cansat-tsniimash/CanSat-Monolit-2022/models/Снимок 2-3a.PNG

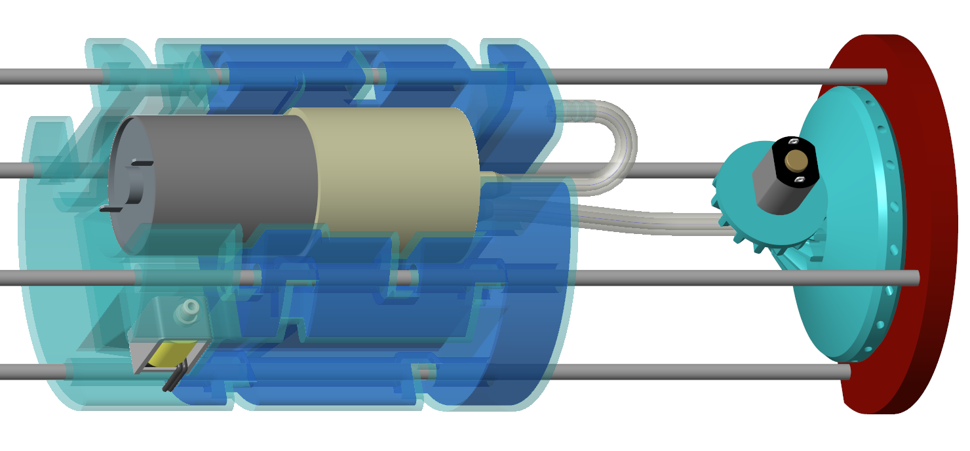
models/Снимок 2-3a.PNG
