cansat-tsniimash/CanSat-Monolit-2022/models/Снимок 1-1.PNG

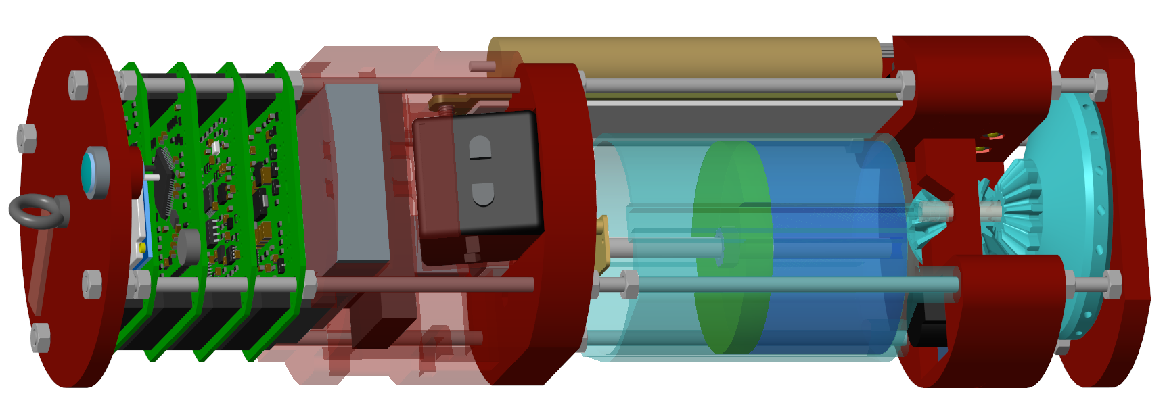
models/Снимок 1-1.PNG
