cansat-tsniimash/CanSat-Monolit-2022/doc/Сегмент парашюта.docx

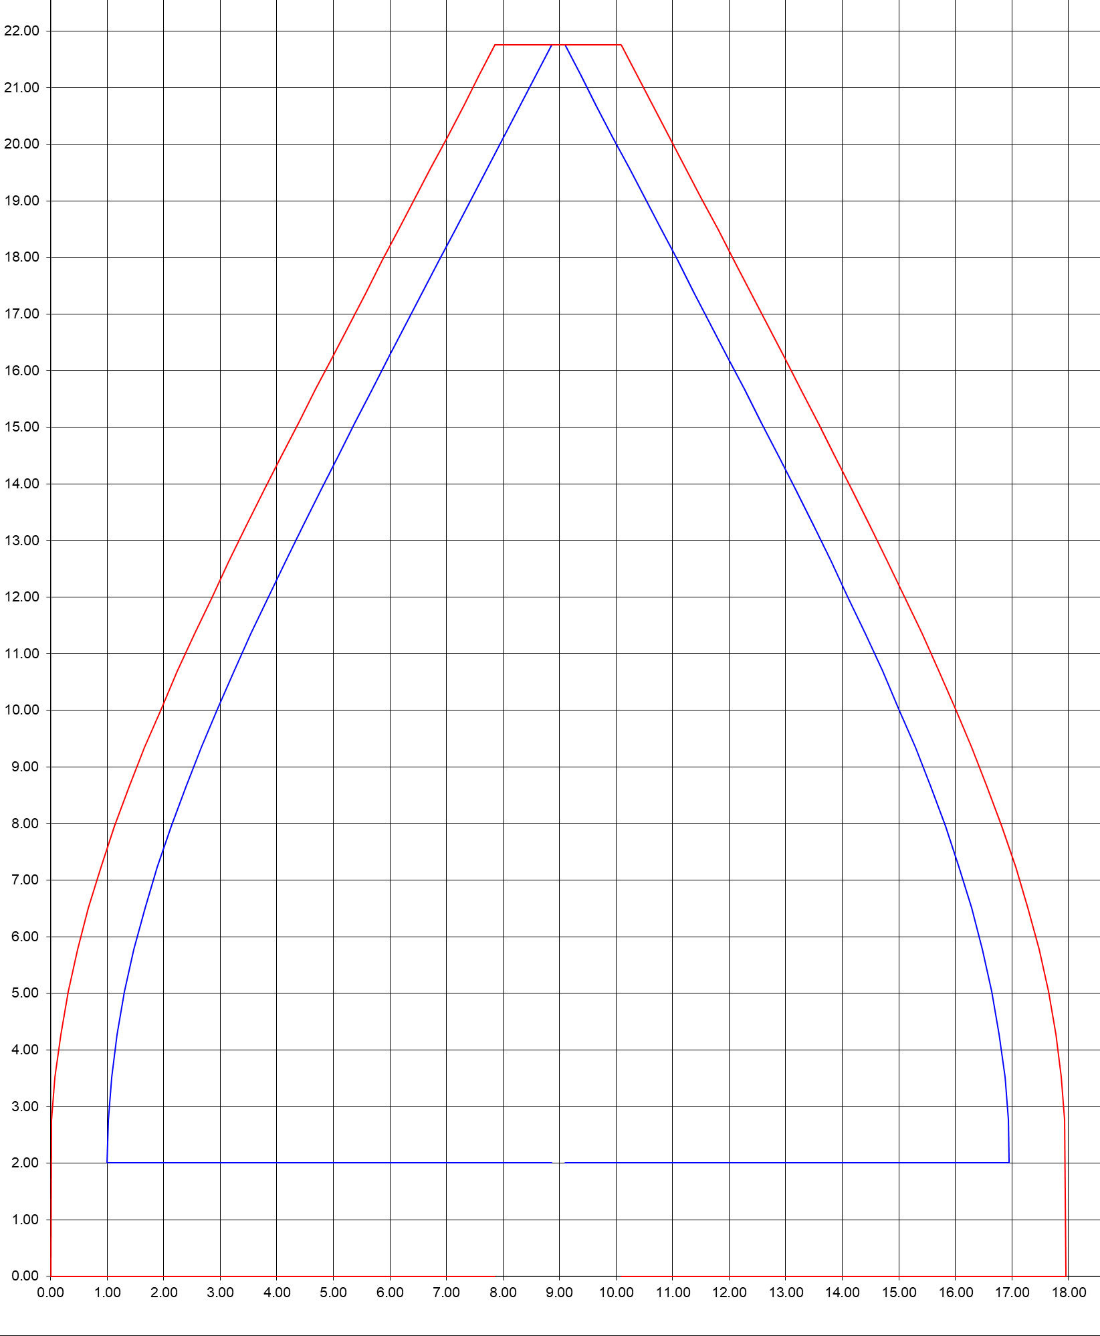
[picture p3: figure]
