cansat-tsniimash/CanSat-Monolit-2022/doc/Презентация Монолит.pdf

# Команда “Монолит”

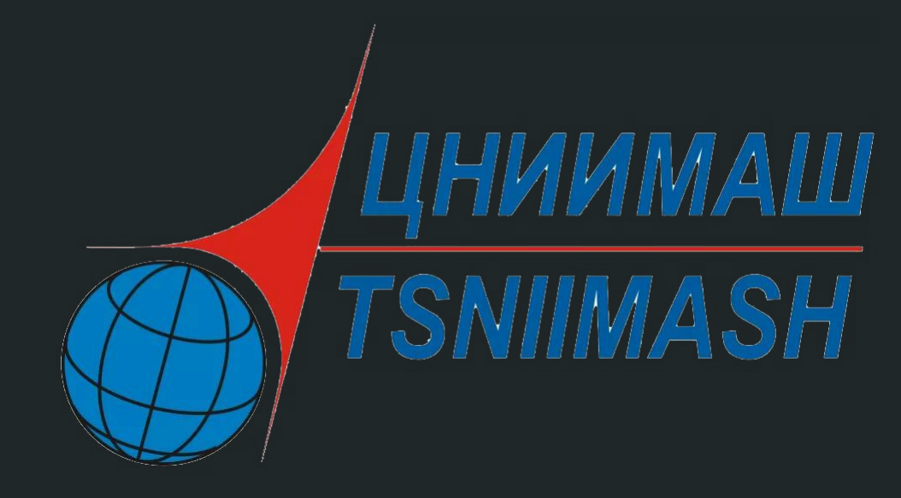
[picture p4: figure]

Проект
“Воздушно-инженерная школа (CanSat в России)”

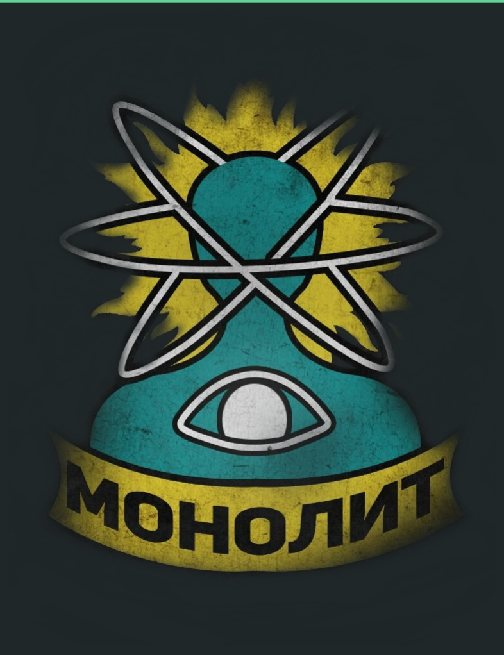
[picture p5: figure]

### Команда

### Алексеев Мирослав

Программист, схемотехник

### Зеленкевич Андрей

Конструктор, схемотехник

### Кулиш Павел

Программист

### Куратор

### Черкасова Марина

7 год участия в ВИШ

# Обязательные задачи проекта

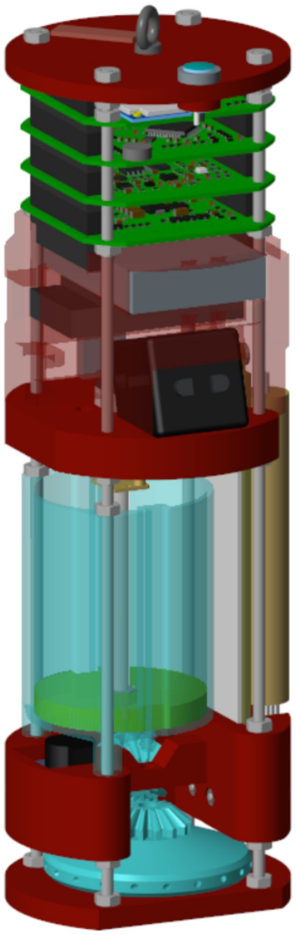
[picture p6: figure]
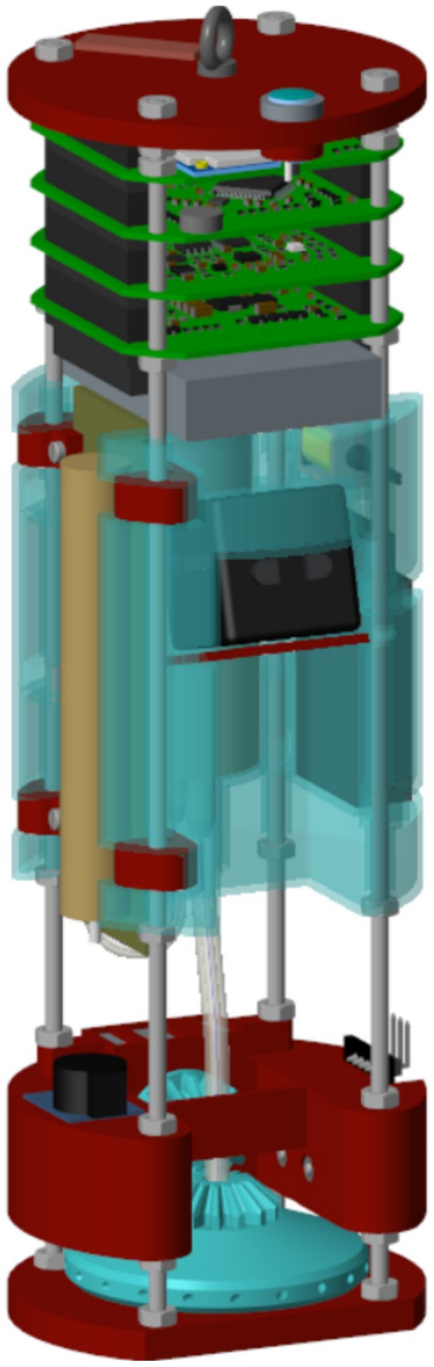
[picture p7: figure]

- Измерение распределения температуры и давления во время подъема и спуска
- Получение и интерпретация данных 3-х осевого акселерометра
- Обеспечение скорости спуска в пределах 5-11 м/c
- Передача данных измерений по обязательным исследовательским задачам в процессе полёта аппарата на приемную станцию
- Обеспечение работы бортового оборудования не менее 3 часов

# Исследовательская задача

### - Общая исследовательская задача - отработка технологий для

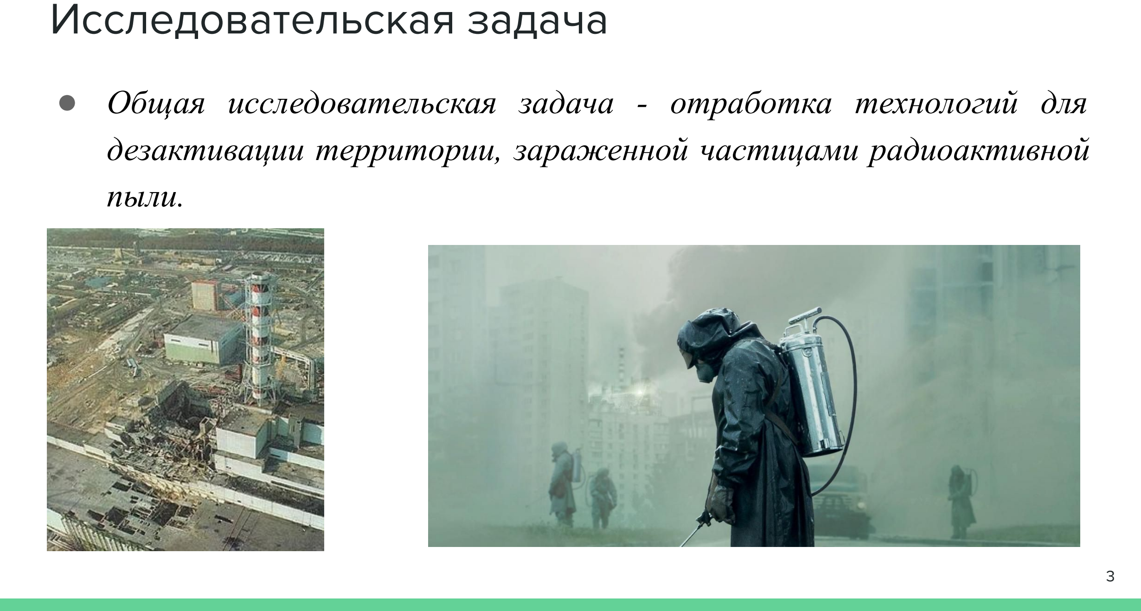
[picture p8: page 3]

### дезактивации территории, зараженной частицами радиоактивной

пыли.

- Измерение степени радиоактивного заражения территории
- Распыление дезактивирующей жидкости
- Видеосъемка процесса распыления жидкости
- Прием телеметрии аппарата на собственной наземной станции
- Использование радиомаяка для поиска аппарата
- Измерение влажности воздуха на протяжении полёта
- Сбор данных GPS о положении аппарата в пространстве
- Бесконтактная фиксация момента отделения от РН
- Световая индикация состояния миссии
- Сохранение телеметрии на SD карту
- Подача звукового сигнала (писк) для облегчения поиска аппарата
- Построение траектории полета аппарата (после приземления) | 4

# Дополнительные задачи проекта

# Схема деления аппарата

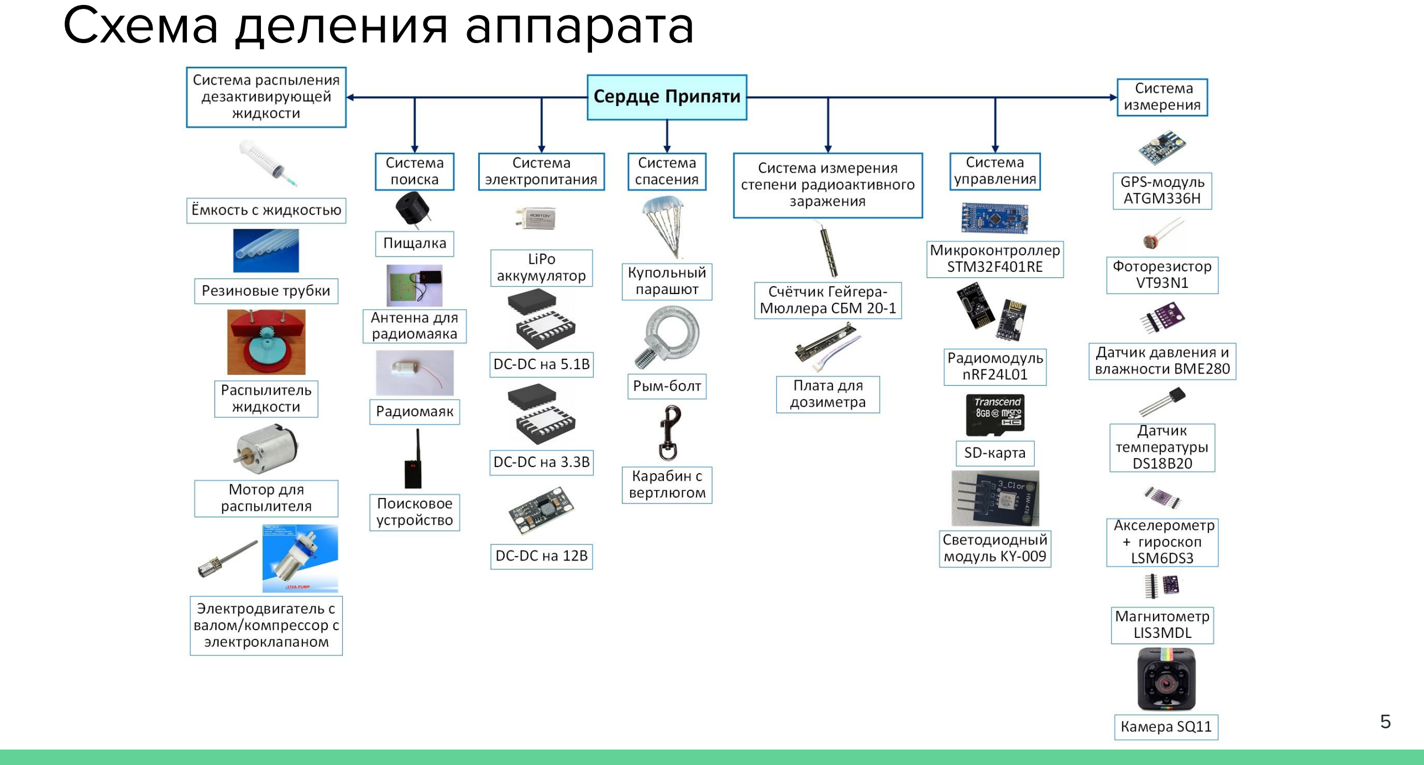
[picture p9: page 5]

# Компоновочная схема аппарата

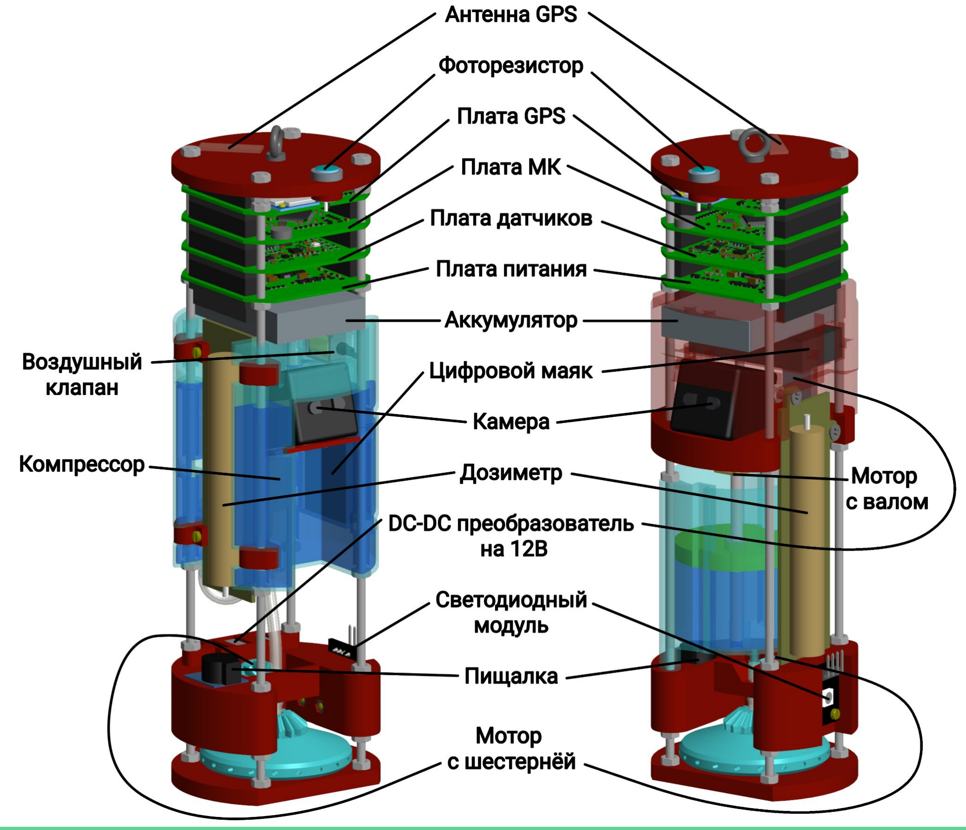
[picture p10: figure]

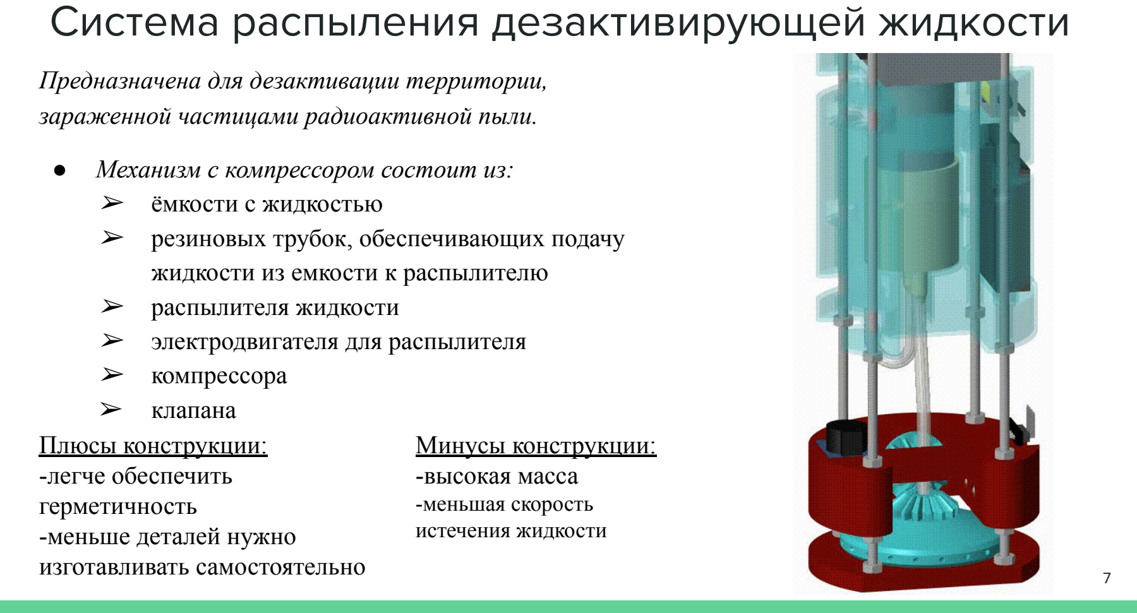
[picture p11: figure]
● Механизм с компрессором состоит из: ➢ ёмкости с жидкостью; жидкости из емкости к распылителю ➢ распылителя жидкости; ➢ электродвигателя для распылителя; ➢ компрессора; ➢ клапана; Плюсы конструкции: -легче обеспечить герметичность -меньше деталей нужно изготавливать самостоятельно; Минусы конструкции: -высокая масса -меньшая скорость истечения жидкости

- резиновых трубок, обеспечивающих подачу

# Система распыления дезактивирующей жидкости

Предназначена для дезактивации территории,
зараженной частицами радиоактивной пыли.

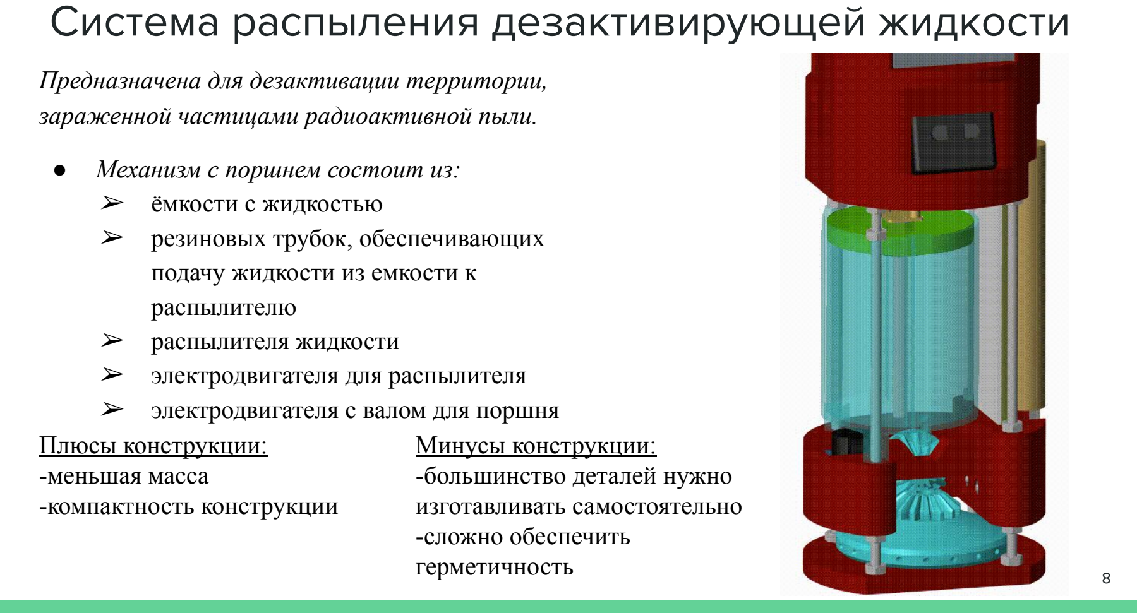
[picture p12: figure]
● Механизм с поршнем состоит из: ➢ ёмкости с жидкостью; ➢ резиновых трубок, обеспечивающих; подачу жидкости из емкости к; распылителю ➢ распылителя жидкости; ➢ электродвигателя для распылителя; ➢ электродвигателя с валом для поршня; Плюсы конструкции: -меньшая масса -компактность конструкции; Минусы конструкции: -большинство деталей нужно изготавливать самостоятельно -сложно обеспечить герметичность

# Система распыления дезактивирующей жидкости

Предназначена для дезактивации территории,
зараженной частицами радиоактивной пыли.

# Исследование радиационной обстановки

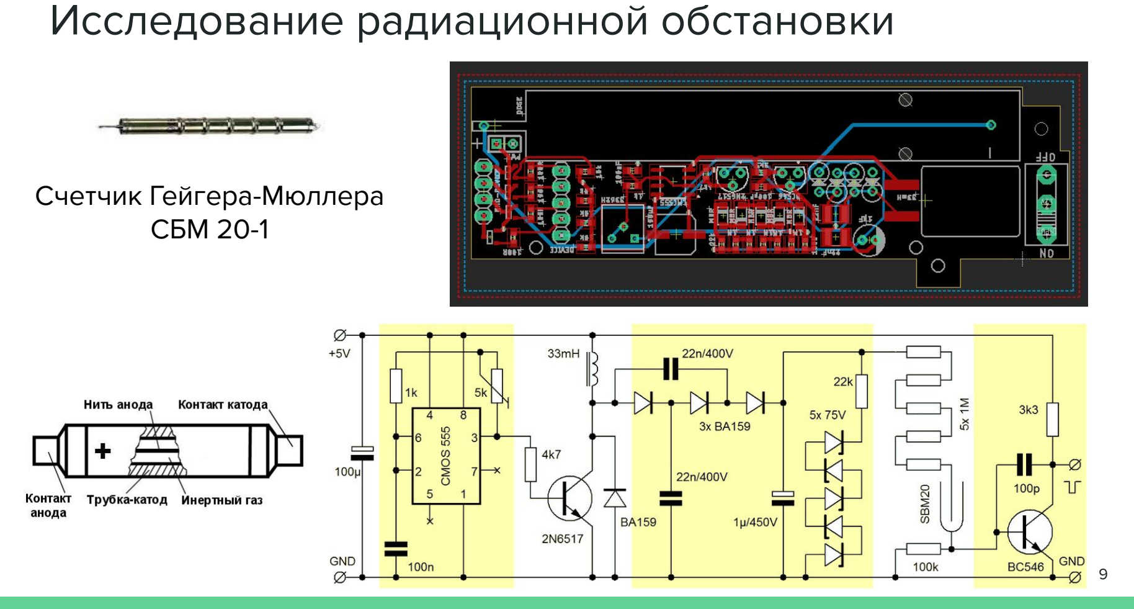
[picture p13: page 9]

### Счетчик Гейгера-Мюллера СБМ 20-1

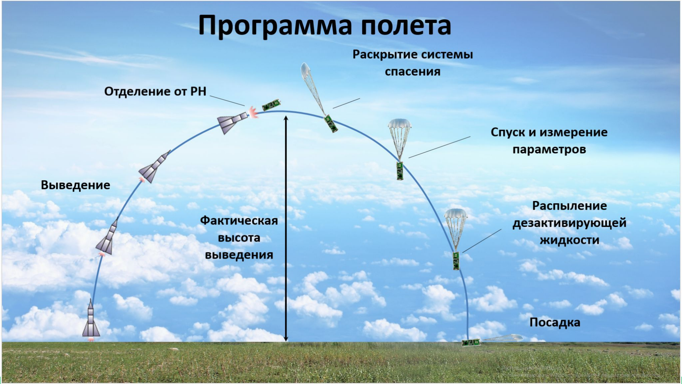
[picture p14: page 10]

# Алгоритм работы аппарата

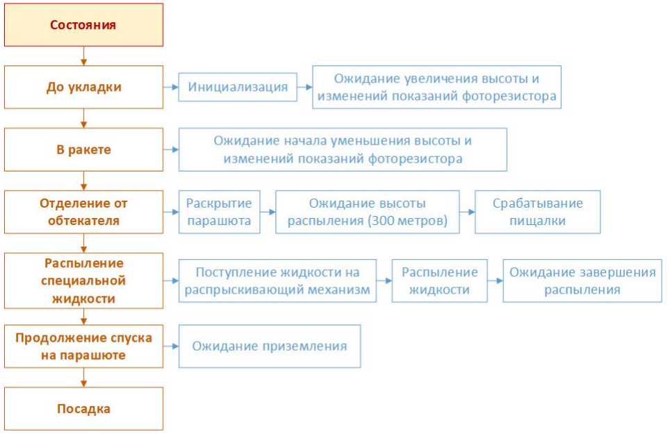
[picture p15: figure]

# Схема подключения электронных компонентов

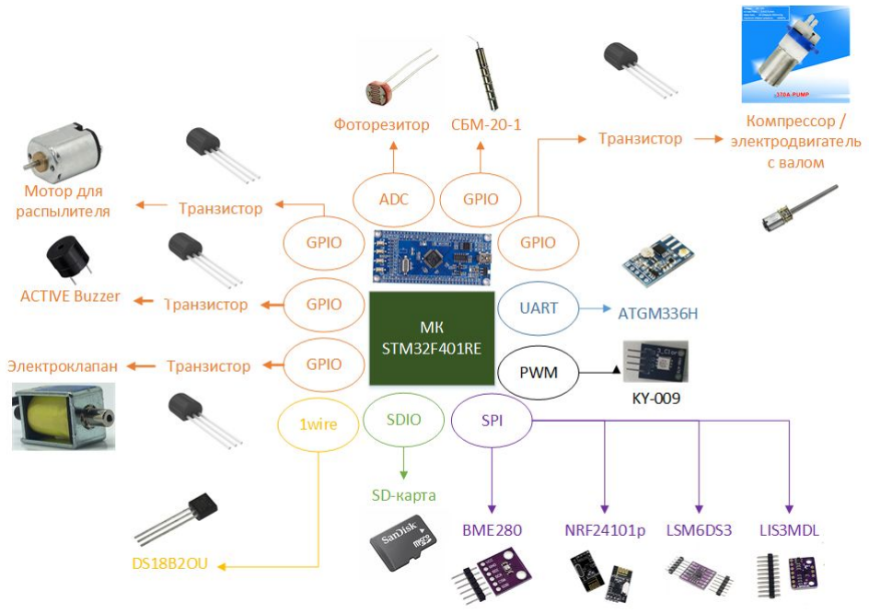
[picture p16: figure]

# Схема распределения питания

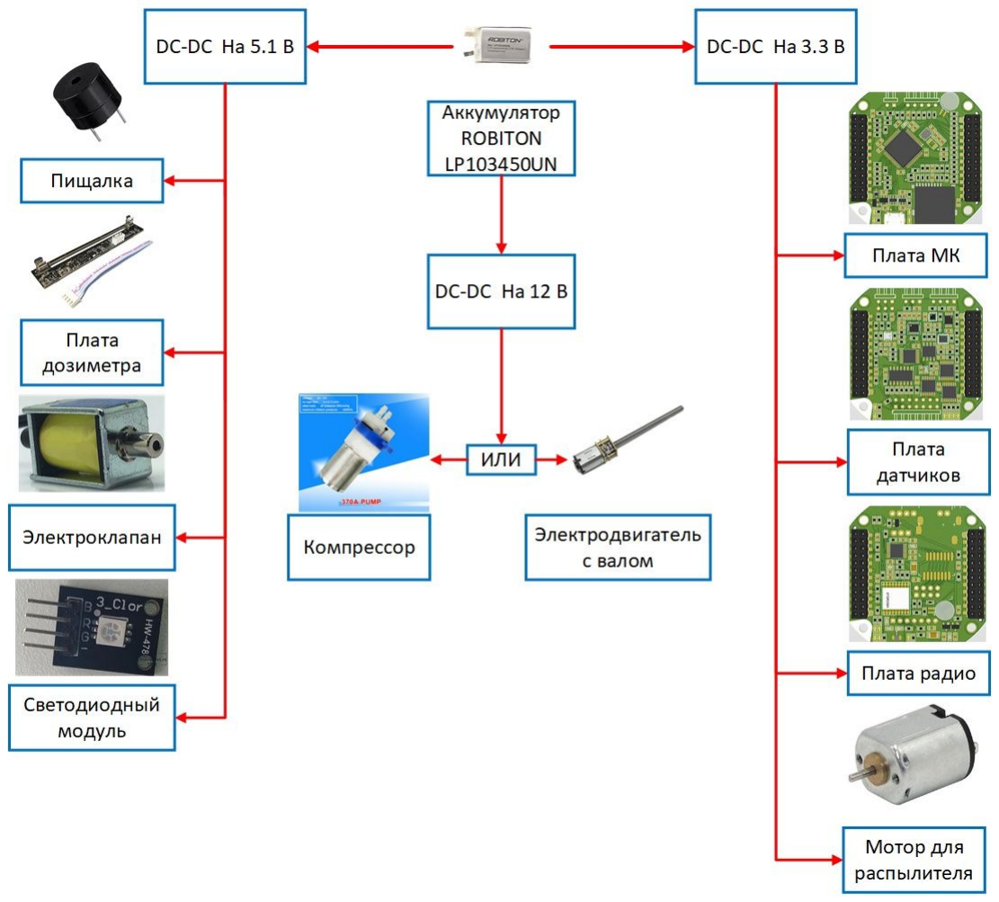
[picture p17: figure]

# Энергобаланс

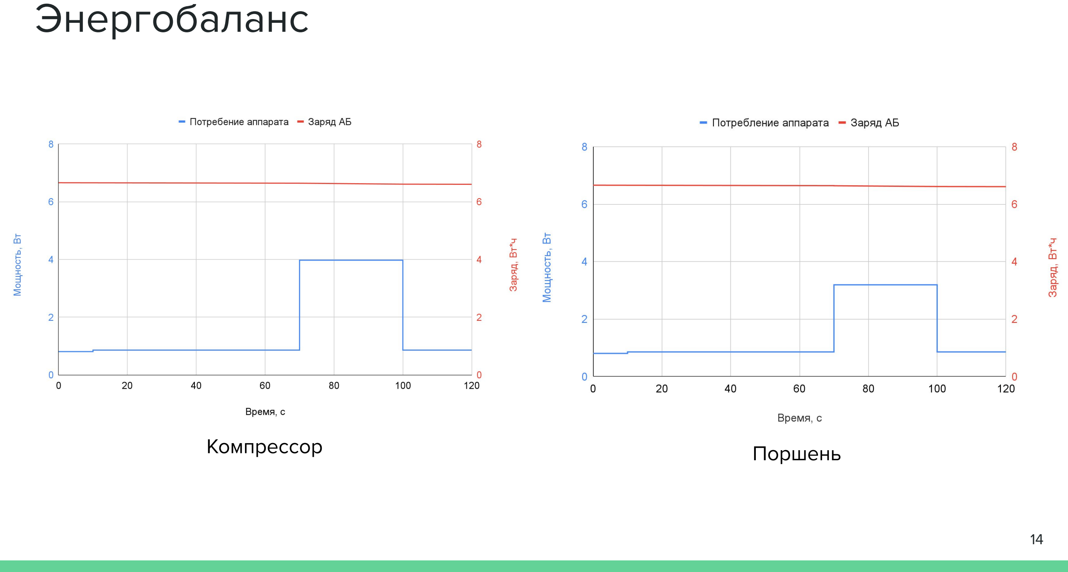
[picture p18: page 14]

Компрессор | Поршень

# Энергобаланс

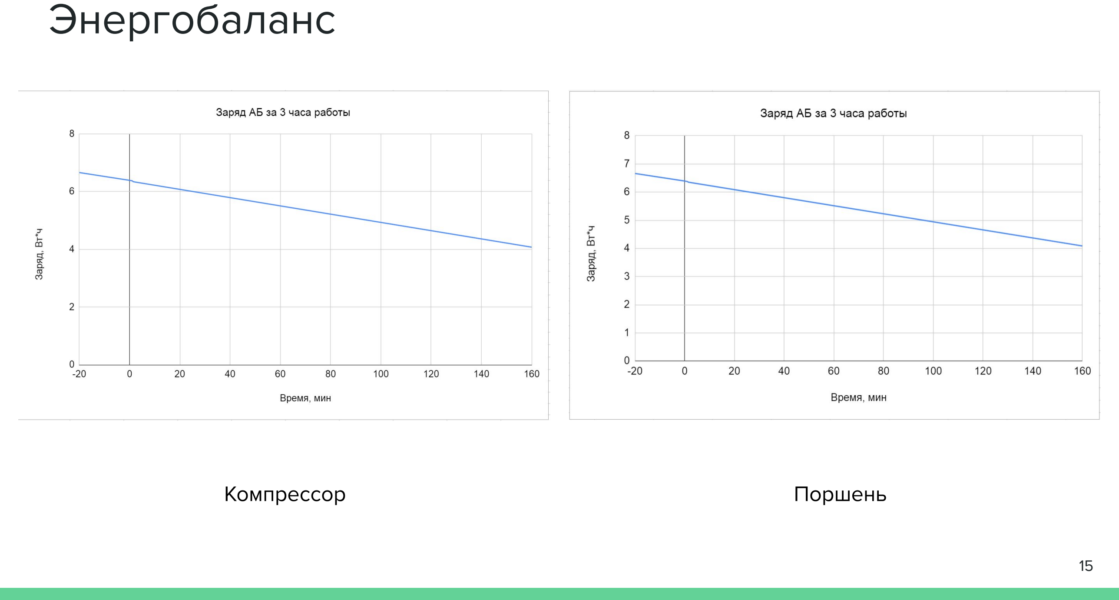
[picture p19: page 15]

Компрессор | Поршень

# Масса и стоимость варианта с компрессором

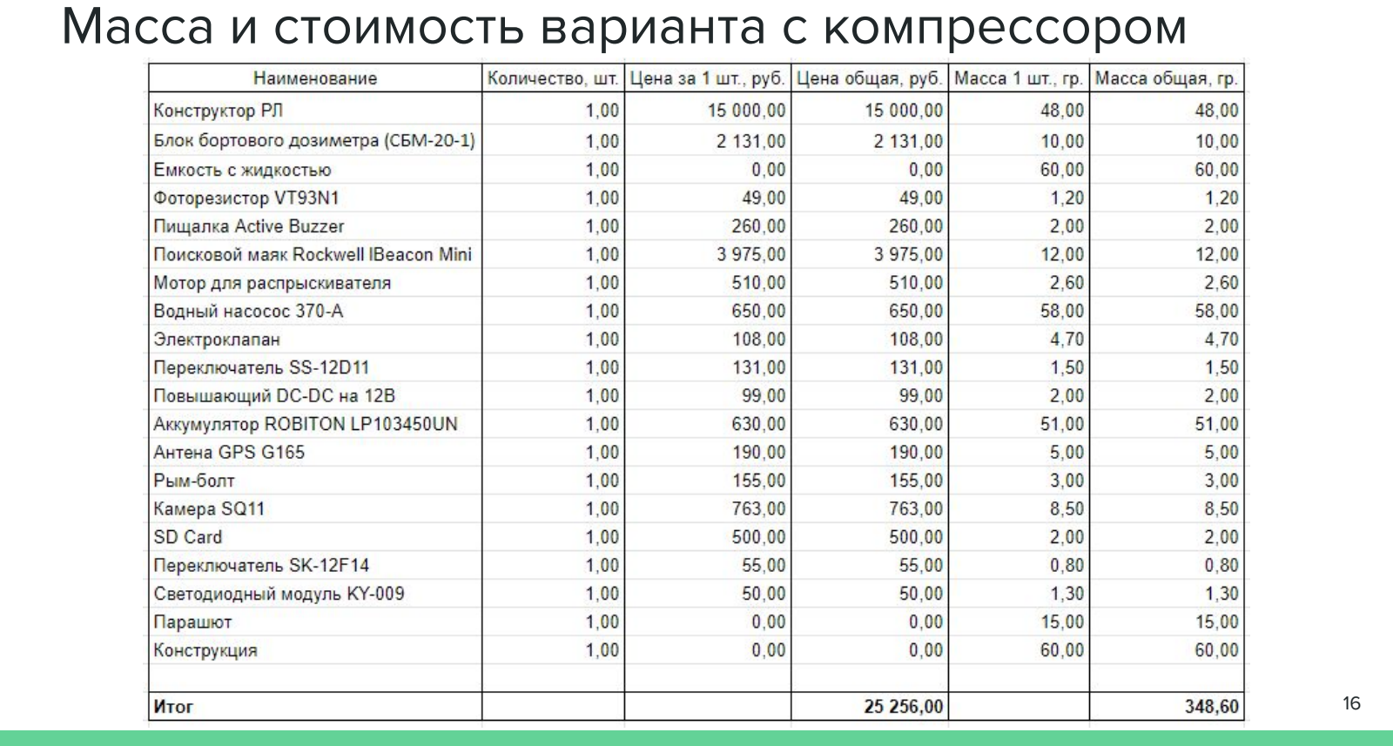
[picture p20: page 16]

# Масса и стоимость варианта с поршнем

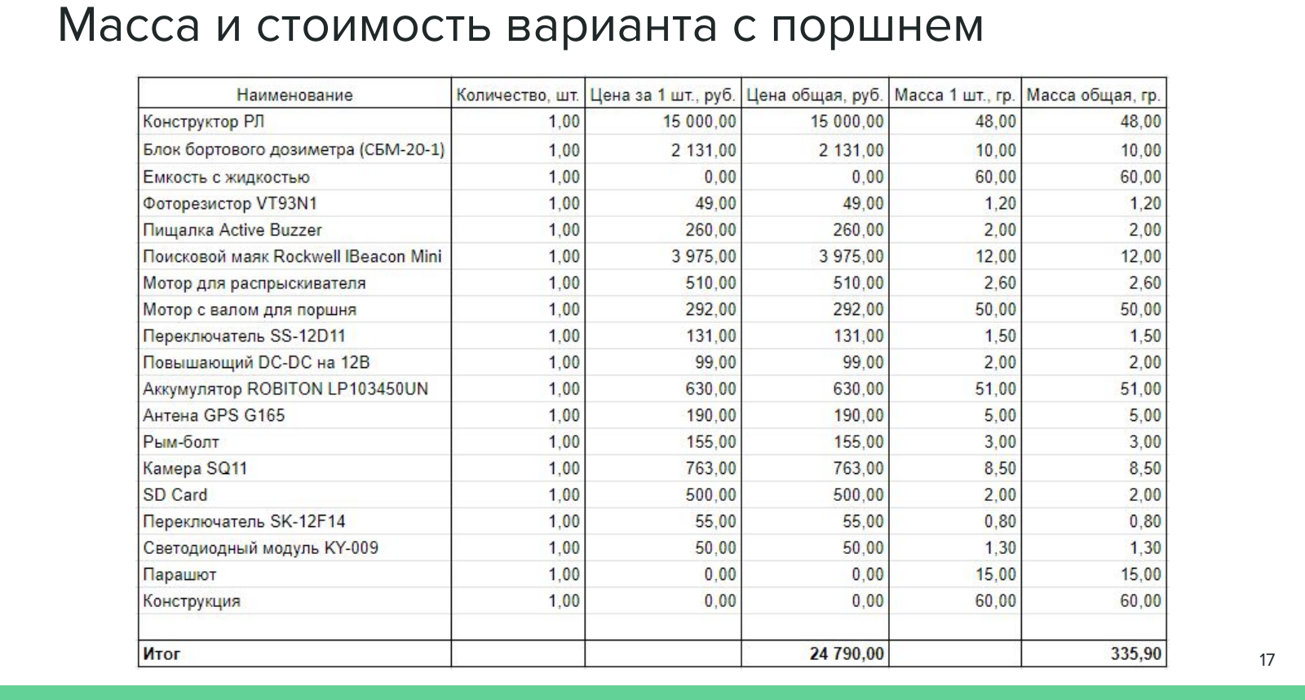
[picture p21: page 17]

# Возможные нештатные ситуации

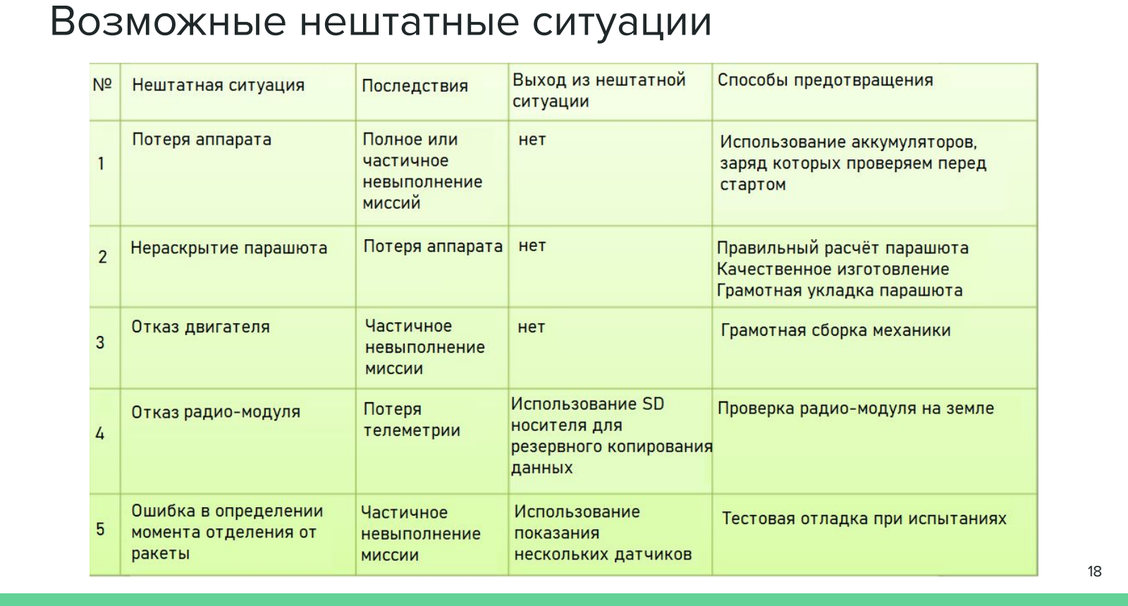
[picture p22: page 18]

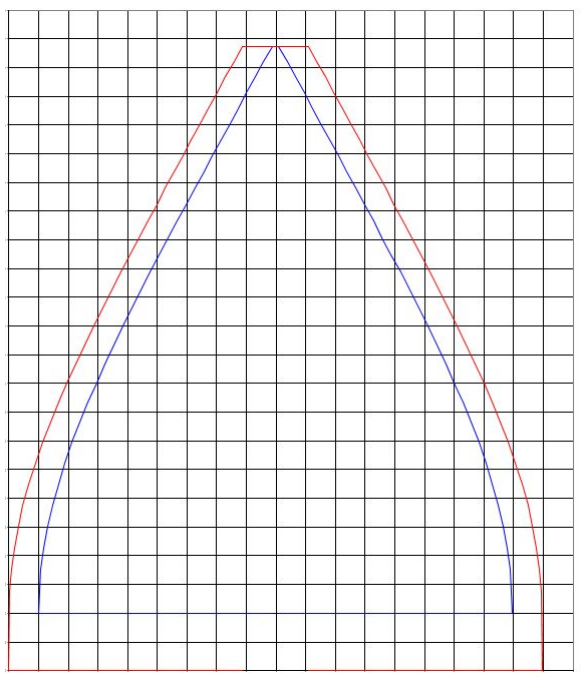
[picture p23: figure]

M – масса аппарата
V – скорость спуска 5-11
g – ускорение свободного падения ρ – плотность воздуха С – коэффициент аэродинамического сопротивления

парашюта 1.2-1.3
S – площадь парашюта
D – диаметр купола парашюта

M = 349 гр

V = 8 м/с

g = 9,81 м/с

2

ρ = 1,225 кг/
м

3

C = 1,2
S = 2Mg/CρV² = 0,073
м

2

D = 4S/π = 0,3047
м

# Расчет парашюта

# Обмен данными

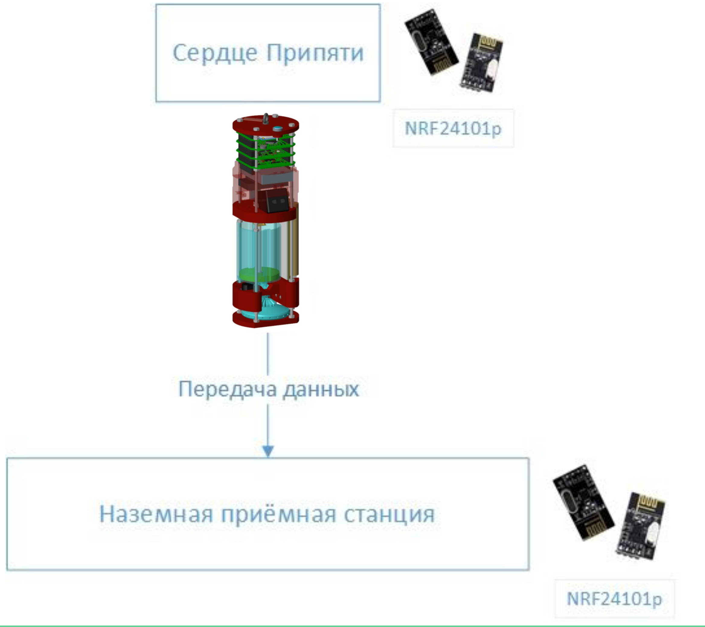
[picture p24: figure]

# Спасибо за внимание!

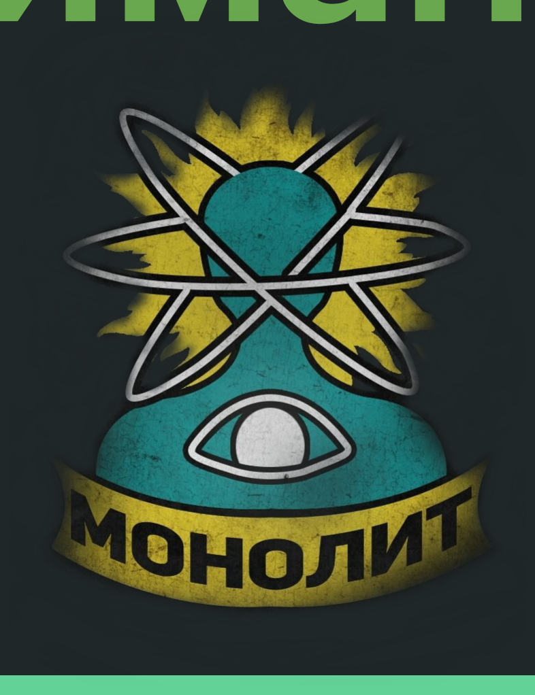
[picture p25: figure]

### Команда

### Алексеев Мирослав

Программист, схемотехник

### Зеленкевич Андрей

Конструктор, схемотехник

### Кулиш Павел

Программист

### Куратор

### Черкасова Марина

## Команда “Монолит”

- Измерение степени радиоактивного заражения территории
- Распыление дезактивирующей жидкости
- Видеосъемка процесса распыления жидкости
- Прием телеметрии аппарата на собственной наземной станции
- Использование радиомаяка для поиска аппарата
- Измерение влажности воздуха на протяжении полёта
- Сбор данных GPS о положении аппарата в пространстве
- Бесконтактная фиксация момента отделения от РН
- Световая индикация состояния миссии
- Сохранение телеметрии на SD карту
- Подача звукового сигнала (писк) для облегчения поиска аппарата
- Построение траектории полета аппарата (после приземления) | 22

# Дополнительные задачи проекта

# Энергопотребление компонентов аппарата

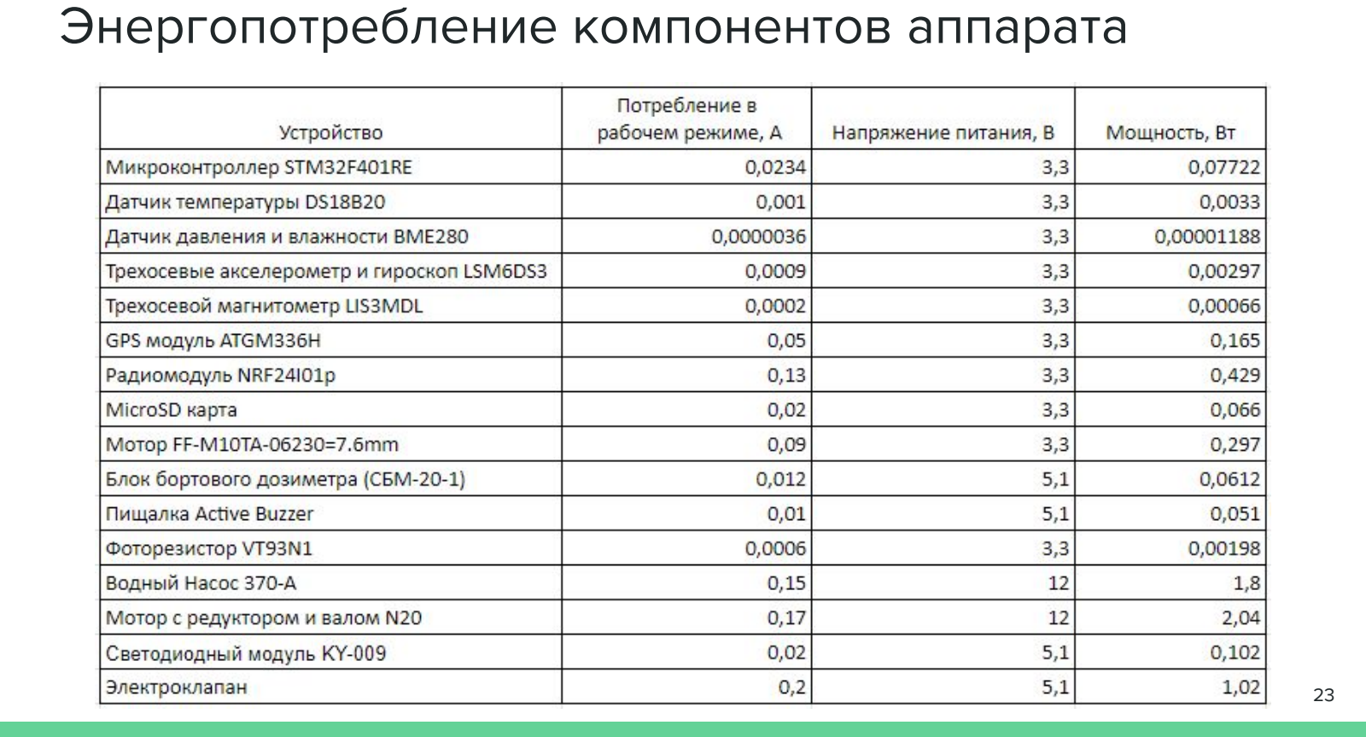
[picture p26: page 23]

# План-график работ

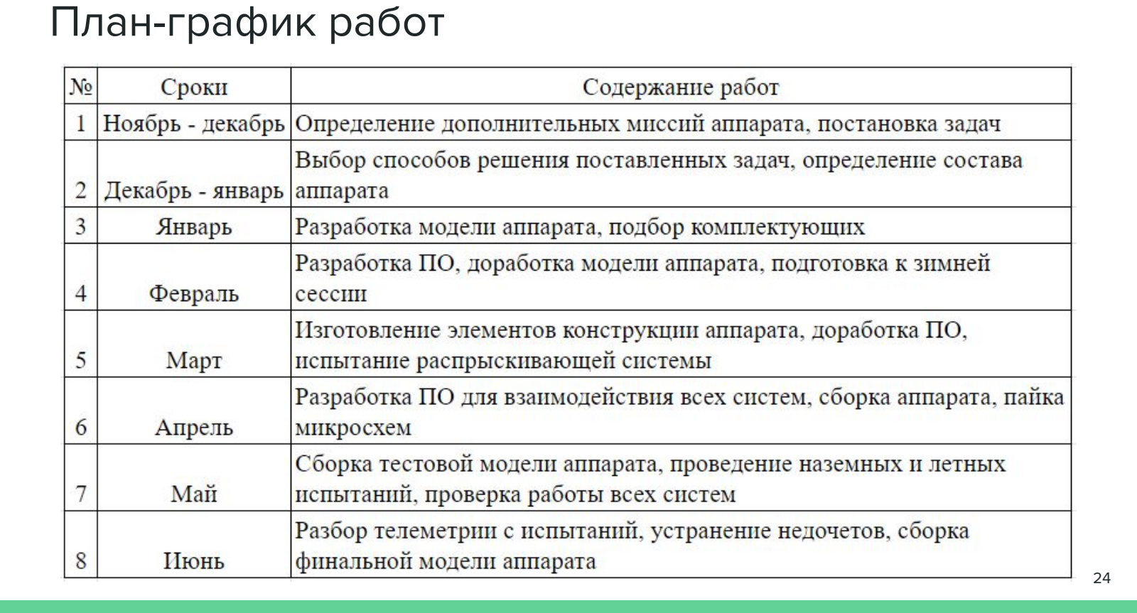
[picture p27: page 24]
