cansat-tsniimash/CanSat-Monolit-2022/models/sborka-1ver.2/Снимок экрана (315).png

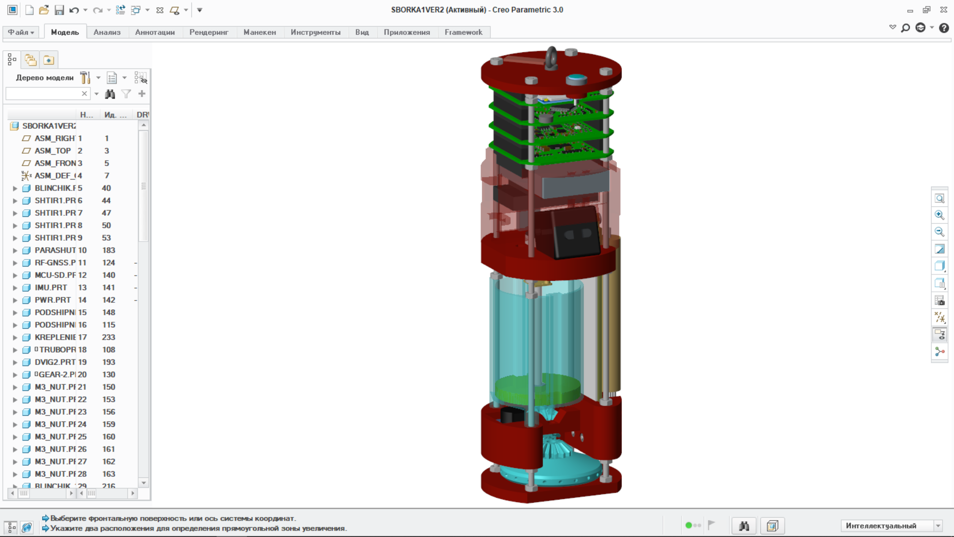
models/sborka-1ver.2/Снимок экрана (315).png
