cansat-tsniimash/CanSat-Monolit-2022/models/sborka-3v2/Снимок экрана (314).png

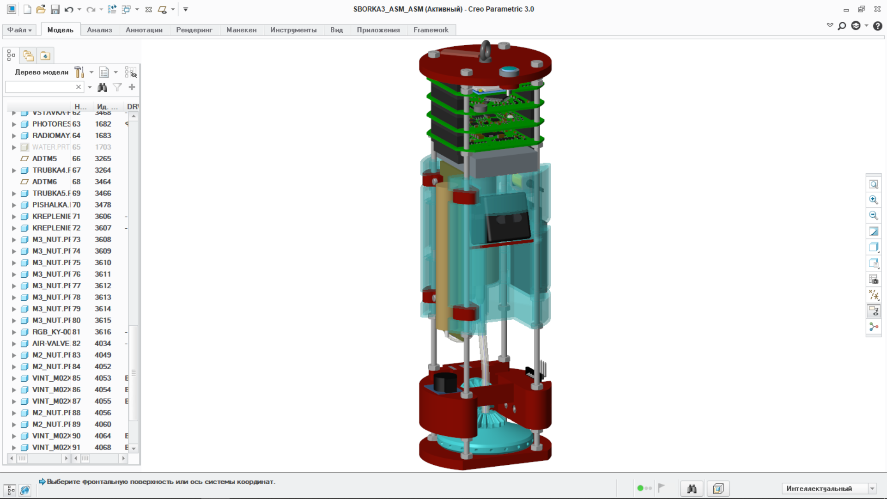
models/sborka-3v2/Снимок экрана (314).png
