cansat-tsniimash/CanSat-Monolit-2022/models/Снимок 1-3.PNG

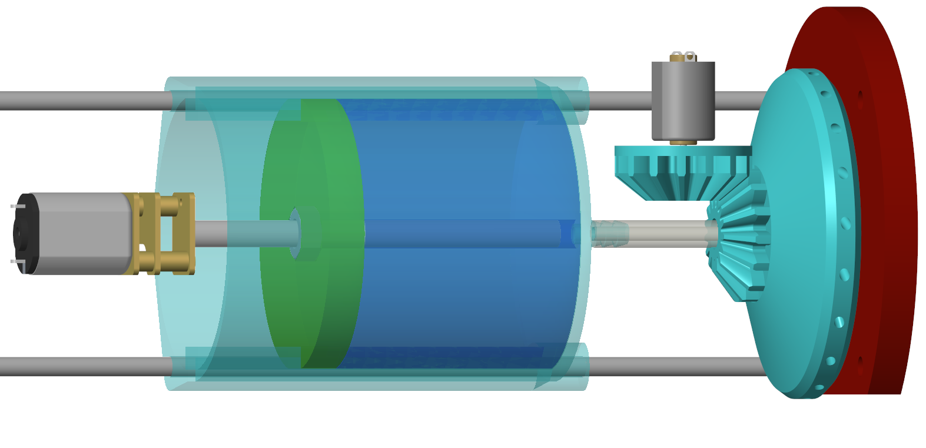
models/Снимок 1-3.PNG
