cansat-tsniimash/CanSat-Monolit-2022/models/Снимок 2-1.PNG

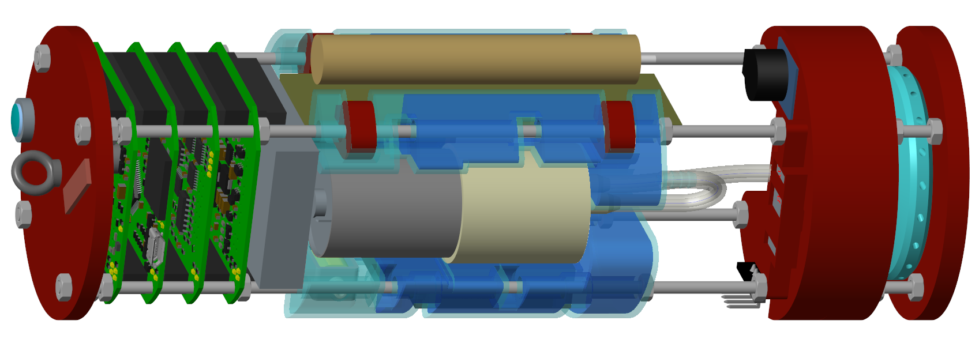
models/Снимок 2-1.PNG
