cansat-tsniimash/CanSat-Monolit-2022/models/Снимок 2-2.PNG

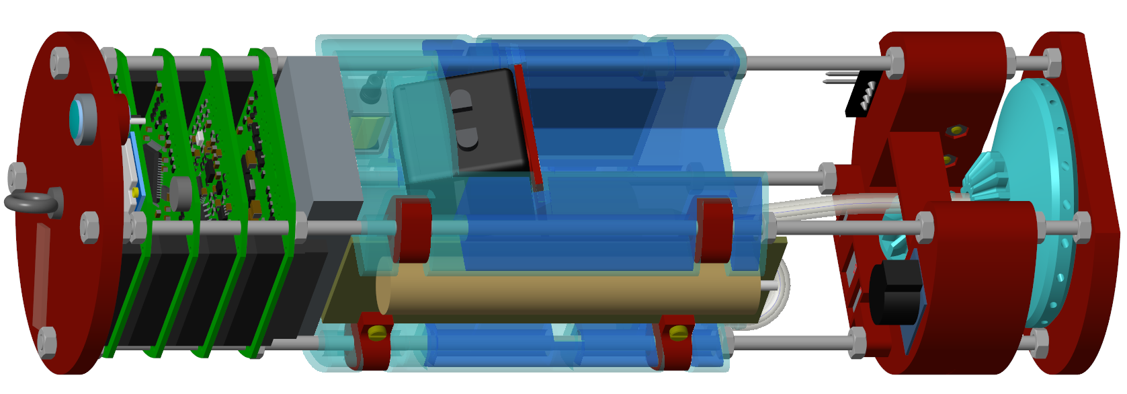
models/Снимок 2-2.PNG
