cansat-tsniimash/CanSat-Monolit-2022/models/Снимок 2-3.PNG

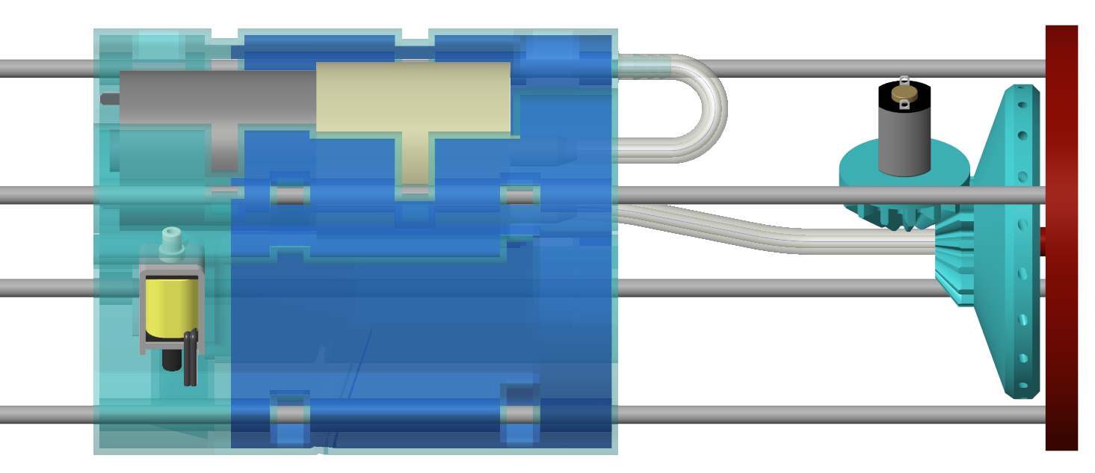
models/Снимок 2-3.PNG
