cansat-tsniimash/CanSat-Monolit-2022/models/details/Gear.stp

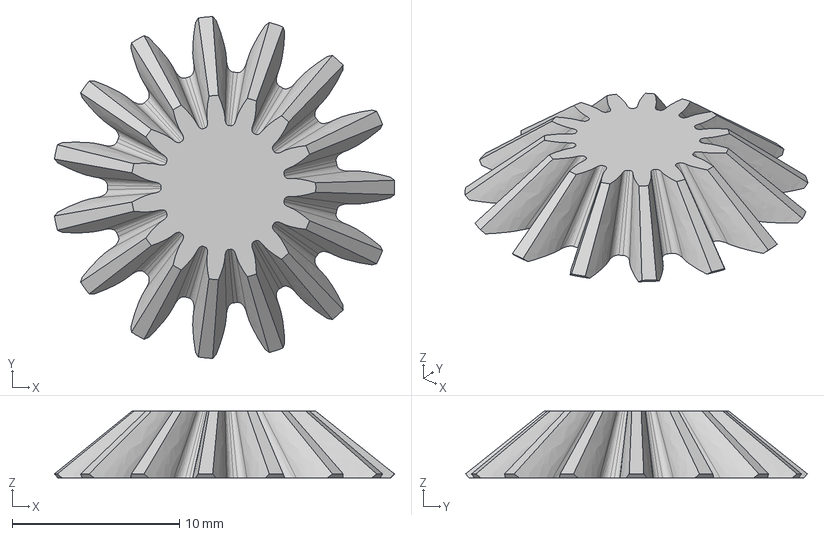
[picture p35: CAD file, 2022-02-16]
models/details/Gear.stp
20.4 x 20.5 x 4.00 mm
