cansat-tsniimash/CanSat-Monolit-2022/(list of files, cad)

Other CAD files:
models/details/akkum.prt
models/details/blinchik.prt
models/details/blinchik4mm.prt
models/details/blinchik_2.prt
models/details/blinchik_3-1-1.prt
models/details/blinchik_3-1.prt
models/details/blinchik_3-2.prt
models/details/blinchik_3-verh2.prt
models/details/blinchik_3.prt
models/details/blinchik_verh.prt
models/details/camera-sq11.prt
models/details/dcdc-12v.prt
models/details/dozimetr.prt
models/details/dvig.prt
models/details/dvig2.prt
models/details/emkoctb.prt
models/details/emkost2.prt
models/details/emkost3.prt
models/details/fotorezistor.prt
models/details/gear-2.prt
models/details/gear.prt
models/details/gear_ne_trogat.prt
models/details/gpska.prt
models/details/kompressor.prt
models/details/kreplenie.prt
models/details/kreplenie2.prt
models/details/krest.prt
models/details/m3_nut.prt
models/details/m4_nut.prt
models/details/motor-reductor-val.prt
models/details/motor-reductor.prt
models/details/niz.prt
models/details/parashut.prt
models/details/parashut1.prt
models/details/photoresistor_vt93n1-.prt
models/details/pin.prt
models/details/pishalka.prt
models/details/podshipnik.prt
models/details/podshipnik4mm.prt
models/details/porshen.prt
models/details/radiomayak.prt
models/details/rim-bolt-m3.prt
models/details/shtir.prt
models/details/shtir1.prt
models/details/trubka1.prt
models/details/trubka2.prt
models/details/trubka3.prt
models/details/truboprobod_norm.prt
models/sborka-1ver.2/akkum.prt
models/sborka-1ver.2/blinchik.prt
models/sborka-1ver.2/blinchik4mm.prt
models/sborka-1ver.2/blinchik_2.prt
models/sborka-1ver.2/blinchik_3-1-1.prt
models/sborka-1ver.2/blinchik_3-1.prt
models/sborka-1ver.2/blinchik_3-2-t.prt
models/sborka-1ver.2/blinchik_3-2.prt
models/sborka-1ver.2/blinchik_3-verh2.prt
models/sborka-1ver.2/blinchik_3.prt
models/sborka-1ver.2/blinchik_verh.prt
models/sborka-1ver.2/camera-sq11-2.prt
models/sborka-1ver.2/camera-sq11.prt
models/sborka-1ver.2/dcdc-12v.prt
models/sborka-1ver.2/dozimetr.prt
models/sborka-1ver.2/dvig.prt
models/sborka-1ver.2/dvig2.prt
models/sborka-1ver.2/emkoctb.prt
models/sborka-1ver.2/emkost2.prt
models/sborka-1ver.2/emkost3.prt
models/sborka-1ver.2/fotorezistor.prt
models/sborka-1ver.2/gear-2.prt
models/sborka-1ver.2/gear.prt
models/sborka-1ver.2/gear_ne_trogat.prt
models/sborka-1ver.2/gpska.prt
models/sborka-1ver.2/kompressor.prt
models/sborka-1ver.2/kreplenie.prt
models/sborka-1ver.2/kreplenie2.prt
models/sborka-1ver.2/kreplenie2v2.prt
models/sborka-1ver.2/kreplenie_dozimetr.prt
models/sborka-1ver.2/krest.prt
models/sborka-1ver.2/m2_nut.prt
models/sborka-1ver.2/m3_nut.prt
models/sborka-1ver.2/m4_nut.prt
models/sborka-1ver.2/motor-reductor-val.prt
models/sborka-1ver.2/motor-reductor.prt
models/sborka-1ver.2/niz.prt
models/sborka-1ver.2/parashut-2.prt
models/sborka-1ver.2/parashut1.prt
models/sborka-1ver.2/photoresistor_vt93n1-.prt
models/sborka-1ver.2/pin.prt
models/sborka-1ver.2/pipe-1.prt
models/sborka-1ver.2/pishalka.prt
models/sborka-1ver.2/podshipnik.prt
models/sborka-1ver.2/podshipnik4mm.prt
models/sborka-1ver.2/porshen.prt
models/sborka-1ver.2/radiomayak.prt
models/sborka-1ver.2/rgb_ky-009-1.prt
models/sborka-1ver.2/rgb_ky-009-2.prt
models/sborka-1ver.2/rim-bolt-m3.prt
models/sborka-1ver.2/shtir.prt
models/sborka-1ver.2/shtir1.prt
models/sborka-1ver.2/trubka1.prt
models/sborka-1ver.2/trubka2.prt
models/sborka-1ver.2/trubka3.prt
models/sborka-1ver.2/truboprobod_norm.prt
models/sborka-1ver.2/vint-m3.prt
models/sborka-1ver.2/vstavka-fotorezistor.prt
models/sborka-1ver.2/vstavka_dozimetr.prt
models/sborka-1ver.2/water.prt
models/sborka-3v2/air-valve.prt
models/sborka-3v2/akkum.prt
models/sborka-3v2/blinchik.prt
models/sborka-3v2/blinchik_3-verh2-2.prt
models/sborka-3v2/camera-sq11.prt
models/sborka-3v2/dcdc-12v0.prt
models/sborka-3v2/dozimetr.prt
models/sborka-3v2/dvig2.prt
models/sborka-3v2/emkost3v.prt
models/sborka-3v2/gear-2.prt
models/sborka-3v2/gpska.prt
models/sborka-3v2/kamera_vstavka.prt
models/sborka-3v2/kompressor.prt
models/sborka-3v2/kreplenie-dcdc.prt
models/sborka-3v2/kreplenie2.prt
models/sborka-3v2/kreplenie2v.prt
models/sborka-3v2/kreplenie_dozimetr1.prt
models/sborka-3v2/krest.prt
models/sborka-3v2/m2_nut.prt
models/sborka-3v2/m3_nut.prt
models/sborka-3v2/parashut.prt
models/sborka-3v2/photoresistor_vt93n1.prt
models/sborka-3v2/pin.prt
models/sborka-3v2/pishalka.prt
models/sborka-3v2/podshipnik.prt
models/sborka-3v2/radiomayak.prt
models/sborka-3v2/rgb_kreplenie.prt
models/sborka-3v2/rgb_ky-009.prt
models/sborka-3v2/rim-bolt-m3.prt
models/sborka-3v2/shtir1.prt
models/sborka-3v2/trubka1.prt
models/sborka-3v2/trubka3.prt
models/sborka-3v2/trubka4.prt
models/sborka-3v2/trubka5.prt
models/sborka-3v2/truboprobod_norm.prt
models/sborka-3v2/vstavka-fotorezistor.prt
models/sborka-3v2/water.prt
