cansat-tsniimash/CanSat-Monolit-2022/board/cansat/Dozimetr.brd

## EAGLE design board/cansat/Dozimetr.brd (2022-05-21)

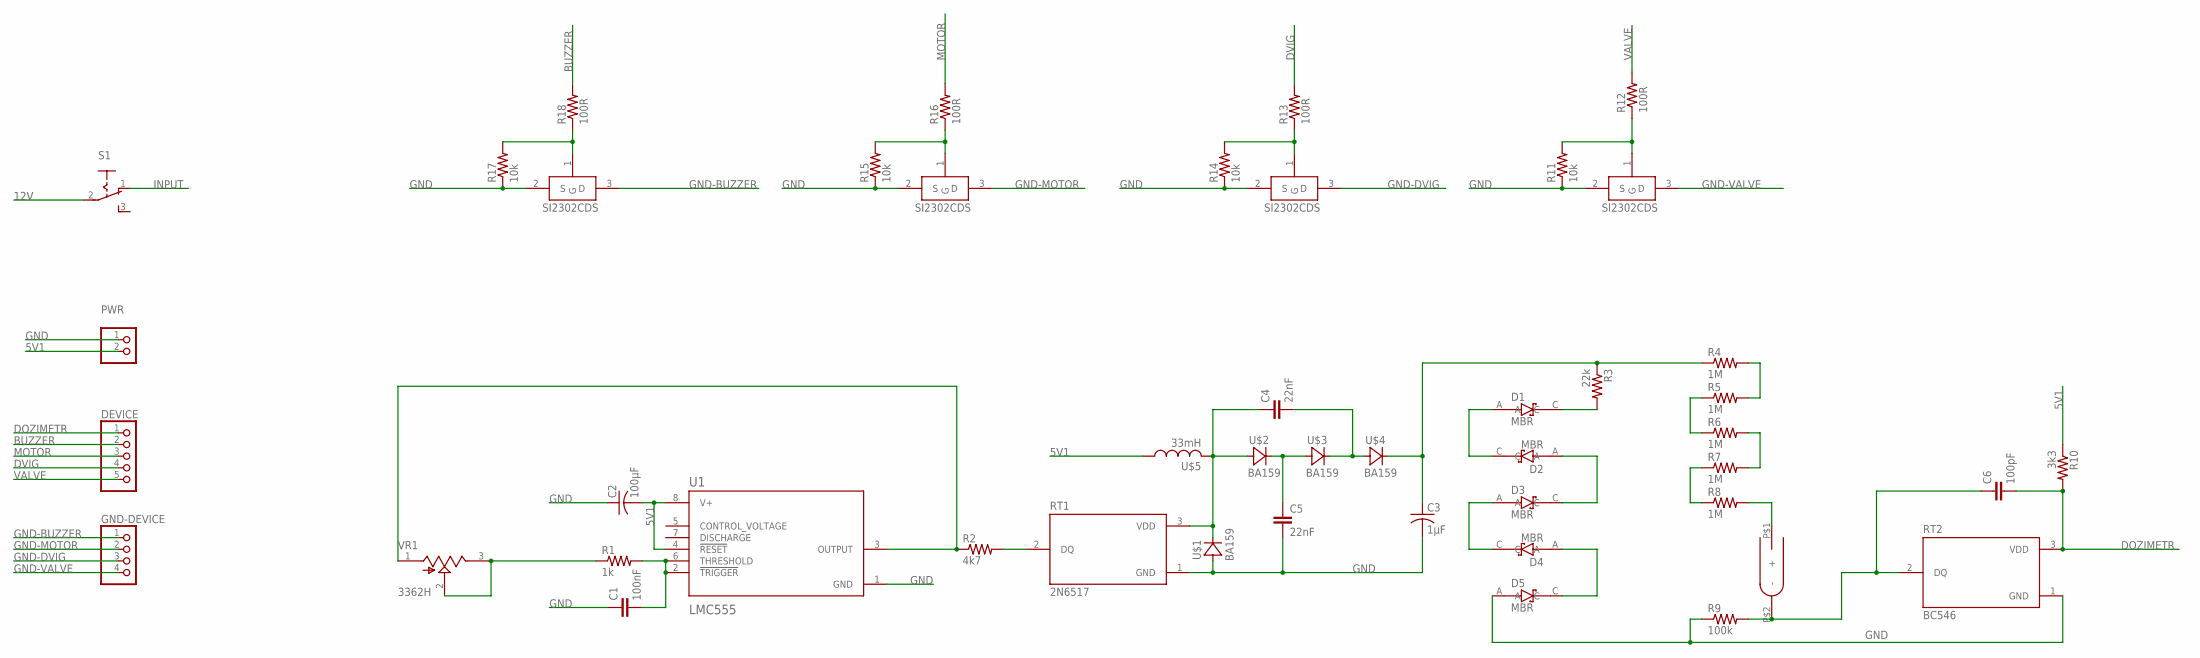
[picture p36: schematic Dozimetr.sch]

Parts:
C1: 100nF; C0603
C2: 100μF; ECAP100-CMD
C3: 1μF; ECAP1MK
C4, C5: 22nF; C1210
C6: 100pF; C0603
D1, D2, D3, D4, D5: MBR; SOD123
DEVICE: PINHD-1X5; 1X05
DOSE: DOSIM_SBM20-1
GND-DEVICE: PINHD-1X4; 1X04
PWR: PINHD-1X2; 1X02
R1: 1k; R0603
R2: 4k7; R0603
R3: 22k; R0603
R4, R5, R6, R7, R8: 1M; R0603
R9: 100k; R0603
R10: 3k3; R0603
R11, R14, R15, R17: 10k; R0603
R12, R13, R16, R18: 100R; R0603
RT1: 2N6517; TO92/TO226
RT2: BC546; TO92/TO226
S1: SWITCH-BIG
SI2302-1, SI2302-2, SI2302-3, SI2302-4: SI2302CDS; SOT23-3
U1: LMC555; SOIC127P599X175-8N
U$1, U$2, U$3, U$4: BA159
U$5: 33mH; RCH114NP_-
VR1: 3362H; TRIM_3362H-1-502LF

Connections:
5V1: C2.P$2 (2), PWR.2, R10.1, U1.4 (!RESET!), U1.8 (V+), U$5.P$1 (1)
12V: S1.2
BUZZER: DEVICE.2, R18.2
DOZIMETR: C6.2, DEVICE.1, R10.2, RT2.3 (VDD)
DVIG: DEVICE.4, R13.2
GND: C1.1, C2.P$1 (1), C3.P$2 (2), C5.2, D5.A, PWR.1, R9.1, R11.1, R14.1, R15.1, R17.1, RT1.1 (GND), RT2.1 (GND), SI2302-1.2 (S), SI2302-2.2 (S), SI2302-3.2 (S), SI2302-4.2 (S), U1.1 (GND), U$1.P$1 (A)
GND-BUZZER: GND-DEVICE.1, SI2302-1.3 (D)
GND-DVIG: GND-DEVICE.3, SI2302-3.3 (D)
GND-MOTOR: GND-DEVICE.2, SI2302-2.3 (D)
GND-VALVE: GND-DEVICE.4, SI2302-4.3 (D)
INPUT: S1.1 (O)
MOTOR: DEVICE.3, R16.2
unnamed: C1.2, R1.2, U1.2 (!TRIGGER!), U1.6 (THRESHOLD)
unnamed: R1.1, VR1.2 (WIPER), VR1.3 (CW)
unnamed: R2.1, U1.3 (OUTPUT), VR1.1 (CCW)
unnamed: C4.1, RT1.3 (VDD), U$1.P$2 (C), U$2.P$1 (A), U$5.P$2 (2)
unnamed: R2.2, RT1.2 (DQ)
unnamed: C5.1, U$2.P$2 (C), U$3.P$1 (A)
unnamed: C4.2, U$3.P$2 (C), U$4.P$1 (A)
unnamed: C3.P$1 (1), R3.1, R4.1, U$4.P$2 (C)
unnamed: D4.A, D5.C
unnamed: D3.A, D4.C
unnamed: D2.A, D3.C
unnamed: D1.A, D2.C
unnamed: D1.C, R3.2
unnamed: R4.2, R5.2
unnamed: R5.1, R6.1
unnamed: R6.2, R7.2
unnamed: R7.1, R8.1
unnamed: DOSE.P$1 (+), R8.2
unnamed: C6.1, DOSE.P$2 (-), R9.2, RT2.2 (DQ)
unnamed: R17.2, R18.1, SI2302-1.1 (G)
unnamed: R15.2, R16.1, SI2302-2.1 (G)
unnamed: R13.1, R14.2, SI2302-3.1 (G)
unnamed: R11.2, R12.1, SI2302-4.1 (G)
VALVE: DEVICE.5, R12.2

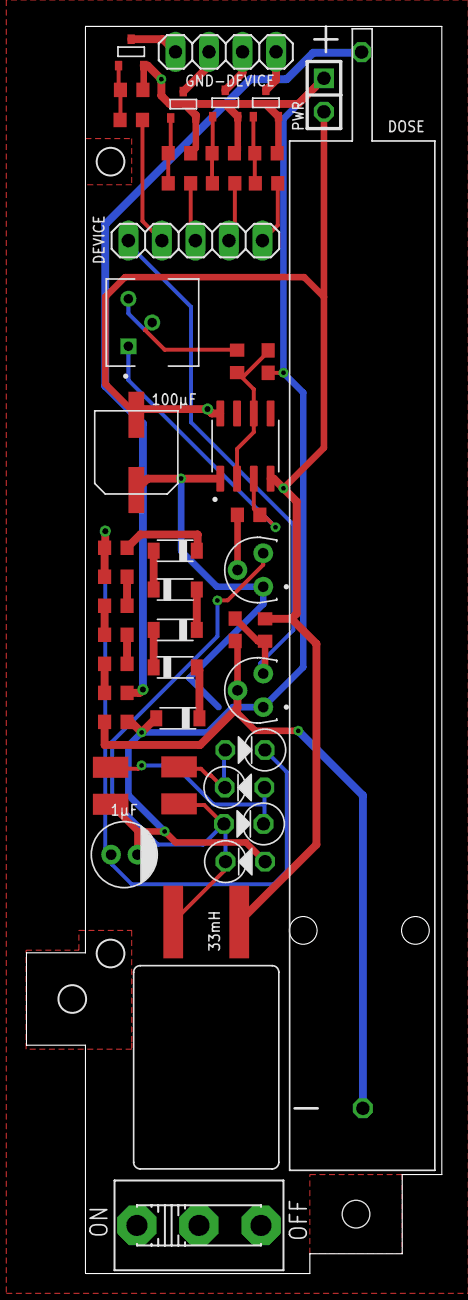
[picture p37: board Dozimetr.brd from above]

Board: 2 copper layers, 31.5 x 94.5 mm, 47 parts (0 on the bottom side), 34 nets.
