cansat-tsniimash/CanSat-Monolit-2022/Research/KodApparata/KodApparata.ioc

Mcu.UserName=STM32F401RCTx
PA10.Signal=USART1_RX
PA13.Signal=SYS_JTMS-SWDIO
PA14.Signal=SYS_JTCK-SWCLK
PA15.Signal=GPXTI15
PA4.GPIO_Label=BUZZER
PA4.Signal=GPIO_Output
PA5.GPIO_Label=ENGINE
PA5.Signal=GPIO_Output
PA7.Signal=ADCx_IN7
PA8.GPIO_Label=doZimetr
PA8.Signal=GPXTI8
PA9.Signal=USART1_TX
PB13.Signal=SPI2_SCK
PB14.Signal=SPI2_MISO
PB15.Signal=SPI2_MOSI
PB8.GPIO_Label=COMPRESSOR
PB8.Signal=GPIO_Output
PB9.GPIO_Label=SECOND_LEVER
PB9.Signal=GPIO_Input
PC1.Signal=GPIO_Output
PC10.Signal=SDIO_D2
PC11.Signal=SDIO_D3
PC12.Signal=SDIO_CK
PC13-ANTI_TAMP.Signal=GPIO_Output
PC4.Signal=GPIO_Output
PC5.Signal=GPIO_Output
PC6.Signal=USART6_TX
PC7.Signal=USART6_RX
PC8.Signal=SDIO_D0
PC9.Signal=SDIO_D1
PD2.Signal=SDIO_CMD
