cansat-tsniimash/CanSat-Monolit-2022/Research/gps/Application/app_main.c

#include "gps.h"

#include <stm32f4xx_hal.h>

#include "ATGM336H/nmea_gps.h"




static const char super_data[] =
		"$GPRMC,170904.935,V,3854.928,N,07702.497,W,78.4,1.83,021116,,E*42\r\n"
		"$GPGGA,170905.935,3854.928,N,07702.497,W,0,00,,,M,,M,,*55\r\n"
		"$GPGLL,3854.928,N,07702.497,W,170906.935,V*36\r\n"
		"$GPGSA,A,2,14,12,04,16,17,11,,,,,,,0.1,0.0,0.9*38\r\n"
		"$GPGSV,2,1,06,14,14,200,30,12,43,040,43,04,79,266,23,16,15,261,82*7F\r\n"
		"$GPGSV,2,2,06,17,88,095,74,11,39,185,73*74\r\n"
		"$GPRMC,170910.935,V,3854.926,N,07702.497,W,52.2,1.90,021116,,E*45\r\n"
		"$GPGGA,170911.935,3854.926,N,07702.497,W,0,04,0.0,,M,,M,,*74\r\n"
		"$GPGLL,3854.926,N,07702.497,W,170912.935,V*3D\r\n"
		"$GPGSA,A,3,14,12,04,16,17,11,,,,,,,0.4,0.3,0.6*30\r\n"
		"$GPGSV,2,1,06,14,26,063,21,12,61,195,15,04,15,021,70,16,62,143,57*75\r\n"
		"$GPGSV,2,2,06,17,07,160,17,11,71,259,73*73\r\n"
		"$GPRMC,170916.935,V,3854.924,N,07702.496,W,43.9,1.92,021116,,E*49\r\n"
		"$GPGGA,170917.935,3854.924,N,07702.496,W,0,04,0.3,,M,,M,,*72\r\n"
		"$GPGLL,3854.924,N,07702.496,W,170918.935,V*34\r\n"
		"$GPGSA,A,2,14,12,04,16,17,11,,,,,,,0.2,1.0,0.8*3B\r\n"
		"$GPGSV,2,1,06,14,20,226,15,12,05,177,85,04,22,233,45,16,66,250,54*75\r\n"
		"$GPGSV,2,2,06,17,34,111,16,11,16,335,79*74\r\n"
		"$GPRMC,170922.935,V,3854.923,N,07702.496,W,53.6,1.90,021116,,E*45\r\n"
		"$GPGGA,170923.935,3854.923,N,07702.496,W,0,04,1.0,,M,,M,,*70\r\n"
		"$GPGLL,3854.923,N,07702.496,W,170924.935,V*3C\r\n"
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
		"$GPGSA,A,3,14,12,04,16,17,11,,,,,,,0.7,0.7,0.4*35\r\n"
		"$GPGSV,2,1,06,14,76,125,48,12,76,270,30,04,74,097,30,16,09,220,86*7C\r\n"
		"$GPGSV,2,2,06,17,88,153,85,11,82,191,33*70\r\n"
;



int app_main()
{
	extern UART_HandleTypeDef huart2;
	__HAL_UART_ENABLE_IT(&huart2, UART_IT_RXNE);

	gps_init();
	int i =0;
	while(1)
	{
		gps_push_byte(super_data[i]);
		i++;
		gps_work();
		int64_t cookie;
		int fix_;
		float lat_;
		float lon_;
		float alt_;
		uint64_t time_s;
		uint32_t time_us;
		gps_get_coords(&cookie, &lat_, &lon_, &alt_, &fix_);
		gps_get_alt(&cookie, &alt_);
		gps_get_time(&cookie,&time_s,&time_us);
		printf("time_s = %d\n\r ", (int) time_s);
		printf("time_us = %d\n\r ", (int) time_us);
		printf("lat_ =%f\n\r ", (float) lat_);
		printf("lon_ = %f\n\r ", (float) lon_);
		printf("alt_= %f\n\r ", (float) alt_);
	}
}
/*
int app_main_backup()
{
	int data_size = sizeof(super_data)/sizeof(super_data[0]);

	printf("begun\n");
	printf("=-=-=-=-=-=-=-=-=-=-=-=-=-=-=-=-=-=-=-=-=-=-=-=-=-=-=-=-=-=-=-=-=-=-=-=-\n");
	printf("=-=-=-=-=-=-=-=-=-=-=-=-=-=-=-=-=-=-=-=-=-=-=-=-=-=-=-=-=-=-=-=-=-=-=-=-\n");
	printf("=-=-=-=-=-=-=-=-=-=-=-=-=-=-=-=-=-=-=-=-=-=-=-=-=-=-=-=-=-=-=-=-=-=-=-=-\n");
	printf("=-=-=-=-=-=-=-=-=-=-=-=-=-=-=-=-=-=-=-=-=-=-=-=-=-=-=-=-=-=-=-=-=-=-=-=-\n");

	for (int i = 0; i < data_size; i++)
	{
		gps_parse(super_data[i]);
		if (pavel_gps_sost == 2)
		{
			// Мы накопили сообщение. Можно его разбирать
			pavel_gps_sost = 0;
			enum minmea_sentence_id id;
			id = minmea_sentence_id(pavel_gps_buffer);
			if (id != MINMEA_SENTENCE_GGA)
			{
				printf("not gga %d\n\r", id);
				continue;
			}

			struct minmea_sentence_gga gga;
			bool succes = minmea_parse_gga(&gga, pavel_gps_buffer);
			if (!succes)
			{
				printf("not success\n");
				continue;
			}

			printf("lat = %f\n\r ", minmea_tocoord(&gga.latitude));
			printf("lon = %f\n\r", minmea_tocoord(&gga.longitude));
			printf("\n");
		}
	}

	return 0;
}
*/
