cansat-tsniimash/CanSat-Monolit-2022/Research/KodApparata/Core/Inc/main.h

#define BUZZER_Pin GPIO_PIN_4
#define BUZZER_GPIO_Port GPIOA
#define ENGINE_Pin GPIO_PIN_5
#define ENGINE_GPIO_Port GPIOA
#define doZimetr_Pin GPIO_PIN_8
#define doZimetr_GPIO_Port GPIOA
#define doZimetr_EXTI_IRQn EXTI9_5_IRQn
#define COMPRESSOR_Pin GPIO_PIN_8
#define COMPRESSOR_GPIO_Port GPIOB
#define SECOND_LEVER_Pin GPIO_PIN_9
#define SECOND_LEVER_GPIO_Port GPIOB
