cansat-tsniimash/CanSat-Monolit-2022/(commit log)

2022-02-16 Залиты все модели
    [Gear.stp, air-valve.prt, akkum.prt, blinchik.prt, blinchik4mm.prt, blinchik_2.prt, blinchik_3-1-1.prt, blinchik_3-1.prt]
2022-02-16 Добавлены файлы проектов для BME280, mems, photores
2022-02-23 закинули файлы гпс в гит
2022-02-23 Загружена схема дозиметра
    [Dozimetr.sch, blinchik_3-1.prt, blinchik_3-2-t.prt, blinchik_3-verh2-2.prt, blinchik_3-verh2.prt, camera-sq11-2.prt, camera-sq11.prt, dozimetr.prt]
2022-02-23 Добавлен большой переключатель
2022-02-23 довели до нормы гпс
2022-02-26 схема дозиметра разведена
    [Dozimetr.brd, Dozimetr.sch]
2022-02-26 Расставлены подписи на плате
    [Dozimetr.brd, Dozimetr.sch]
2022-03-02 добавил gitignore シ
2022-03-02 заигнорил файлы папки дебуг
2022-03-02 гит игнор :)
2022-03-02 зачистили неудалившиеся дебаги
2022-03-02 зачистили неудалившиеся сеттингс
2022-03-02 просто добил файлы :)
2022-03-02 обновили библиотеку
2022-03-06 пытаемся сделать картинки в рпз
    [air-valve.prt, blinchik_3-1.prt, blinchik_3-2-t.prt, blinchik_3-verh2-2.prt, blinchik_3-verh2.prt, camera-sq11-2.prt, camera-sq11.prt, dcdc-12v.prt]
2022-03-06 Добавлены картинки сборок
    [emkoctb.prt, pipe-1.prt, porshen.prt, water.prt]
2022-03-19 запилили драйвер на фоторезистор
2022-03-19 перешёл на ласт коммит либ-цниимаша
2022-03-20 Добавлены все файлы по ЗС
    [Dozimetr.brd, parapat_RUS.xls]
2022-03-26 пилили драйвер на бмеху
2022-03-28 сабмодули на относительных путях
2022-05-02 Подушка безопасности
2022-05-02 Новый либ-цниимаш
2022-05-04 Радио работает
2022-05-04 Апп_майн работы с радио
2022-05-04 Датчики работают, А радио нет
2022-05-07 Кодик для шакала на Андрее
2022-05-07 Вкрутили фоторез
2022-05-08 ГПС вкручен, но не ловит данные (надо тестить) и выводит нули
2022-05-11 ЛИСМ вкручен и проверен
2022-05-21 Плата дозиметра готова
    [Dozimetr.brd, Dozimetr.sch]
2022-06-08 Вкручен проверен ДС18, начаты состояния
2022-06-08 Закончены состояния, написаны различные ф-ии
2022-06-08 Написана система безопасности для СД-карты
2022-06-09 Достигнут компромисс с конструкторами по поводу пинов
2022-06-11 ОТЛАДКА
2022-06-15 ПОчинка кнопки
2022-06-15 ФИКС БАГИ С ИНЕРЦИАЛКОЙ + ПРОВЕРКА И ФИКС СОСТОЯНИЙ
2022-06-29 Норм рабочая версия, надо поймать ГПС
2022-06-29 Оказалось, что проблема ГПС - в антенне, написаны косметические ф-ии
